fardog/Toast-R-Reflow/hardware/pcb/Controller_II.kicad_pcb

## KiCad design hardware/pcb/Controller_II.kicad_pcb (2021-08-20)

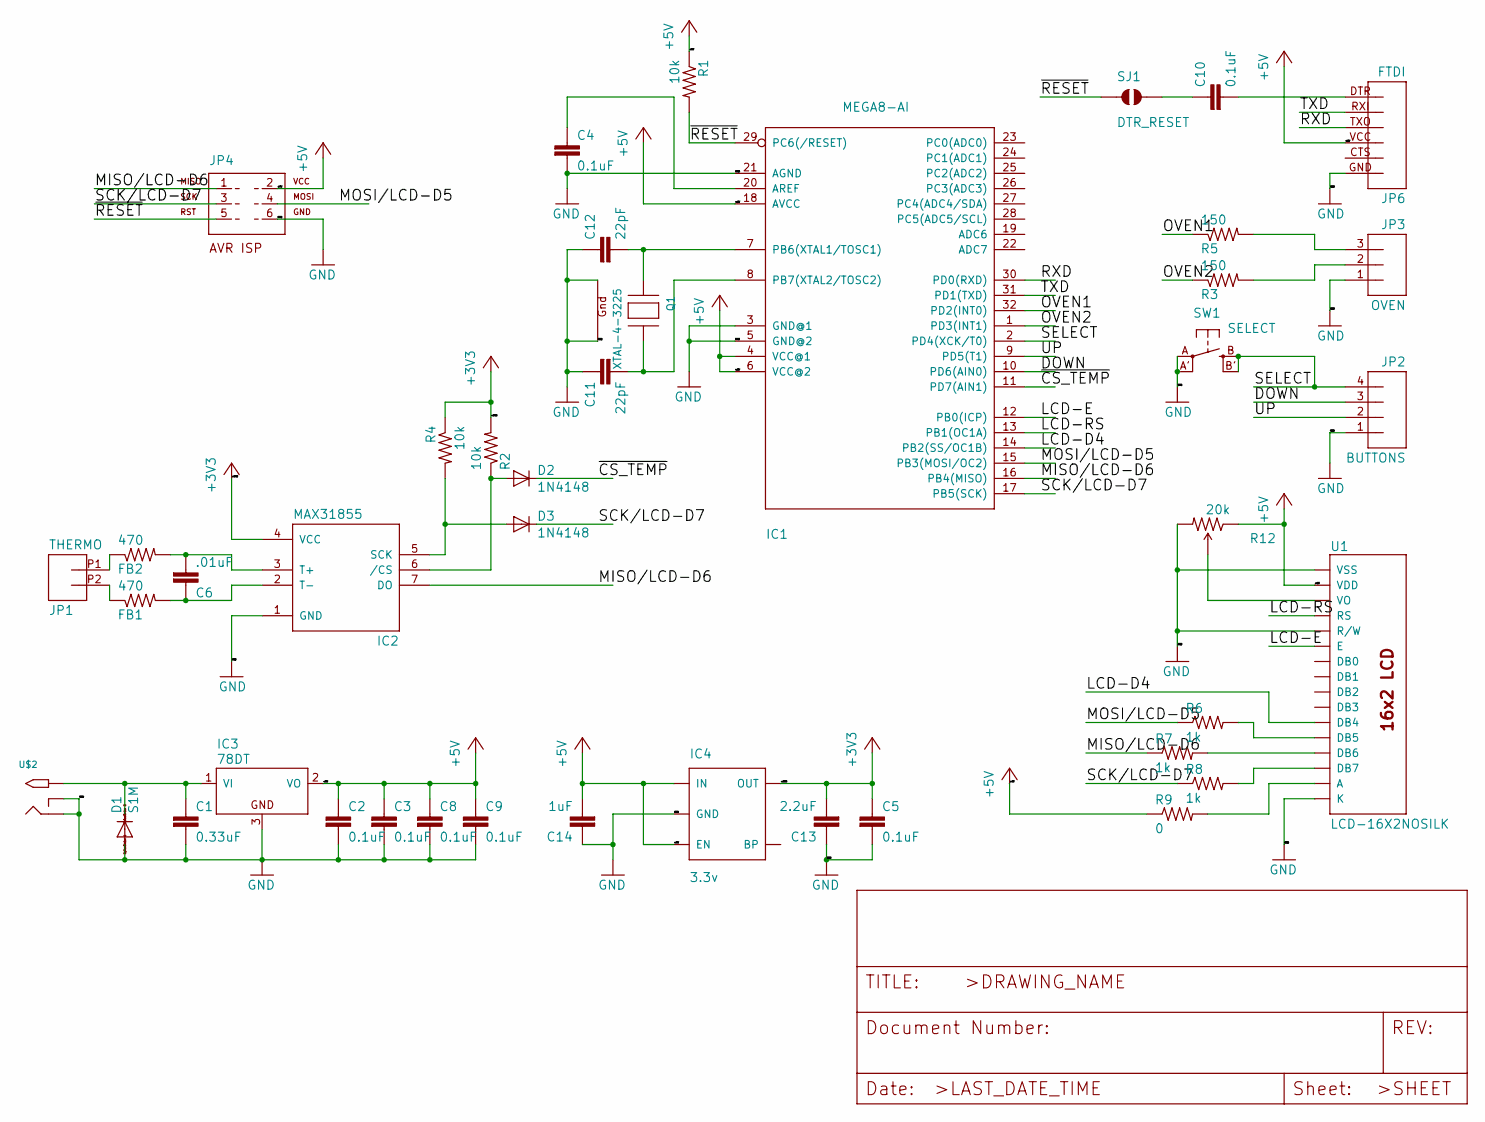
[picture p1: schematic Controller_II.sch]

Parts:
C1: 0.33uF; 0805
C2, C3, C4, C5, C8, C9, C10: 0.1uF; 0805
C6: .01uF; 0805
C11, C12: 22pF; 0805
C13: 2.2uF; 0805
C14: 1uF; 0805
D1: S1M; DO-214AC
D2, D3: 1N4148; SOD-323
FB1, FB2: 470; 0805
IC1: MEGA8-AI; TQFP32-08
IC2: MAX31855; SO08
IC3: 78DT; TO252
IC4: 3.3v; SOT23-5
JP1: THERMO; 1X02_2.54_SCREWTERM
JP2: BUTTONS; 1X04
JP3: OVEN; SCREWTERMINAL-5MM-3
JP4: ISP; AVR-ISP-6
JP6: FTDI; FTDI_BASIC
Q1: XTAL-4-3225; NX3225
R1, R2, R4: 10k; 0805
R3, R5: 150; 0805
R6, R7, R8: 1k; 0805
R9: 0; 0805
R12: 20k; TRIMPOT-3MM
SJ1: DTR_RESET; SJ_2S-NO
SW1: SELECT; EVQ-Q2
U1: LCD-16X2NOSILK; LCD-16X2_NOSILK
U$2: 2.1MMJACKSMT; DCJACK_2MM_SMT

Connections:
+3V3: C5.1, C13.2, IC2.4 (VCC), IC4.5 (OUT), R2.2, R4.1
+5V: C2.1, C3.1, C8.1, C9.1, C14.2, IC1.4 (VCC@1), IC1.6 (VCC@2), IC1.18 (AVCC), IC3.2 (VO), IC4.1 (IN), IC4.3 (EN), JP4.2, JP6.VCC (4), R1.1, R9.1, R12.1 (CCW), U1.2 (VDD)
/DOWN: IC1.10 (PD6(AIN0)), JP2.3
/LCD-D4: IC1.14 (PB2(SS/OC1B)), U1.11 (DB4)
/LCD-E: IC1.12 (PB0(ICP)), U1.6 (E)
/LCD-RS: IC1.13 (PB1(OC1A)), U1.4 (RS)
/MISO/LCD-D6: IC1.16 (PB4(MISO)), IC2.7 (DO), JP4.1, R7.1
/MOSI/LCD-D5: IC1.15 (PB3(MOSI/OC2)), JP4.4, R6.1
/OVEN1: IC1.32 (PD2(INT0)), R5.1
/OVEN2: IC1.1 (PD3(INT1)), R3.1
/RXD: IC1.30 (PD0(RXD)), JP6.TXO (3)
/SCK/LCD-D7: D3.1 (C), IC1.17 (PB5(SCK)), JP4.3, R8.1
/SELECT: IC1.2 (PD4(XCK/T0)), JP2.4, SW1.B (S), SW1.B' (S1)
/TXD: IC1.31 (PD1(TXD)), JP6.RXI (2)
/UP: IC1.9 (PD5(T1)), JP2.2
/~CS_TEMP: D2.1 (C), IC1.11 (PD7(AIN1))
/~RESET: IC1.29 (PC6(/RESET)), JP4.5, R1.2, SJ1.1
GND: C1.2, C2.2, C3.2, C4.2, C5.2, C8.2, C9.2, C11.1, C12.1, C13.1, C14.1, D1.A, IC1.3 (GND@1), IC1.5 (GND@2), IC1.21 (AGND), IC2.1 (GND), IC3.3 (GND), IC4.2 (GND), JP2.1, JP3.1, JP4.6, JP6.GND (6), Q1.2 (G2), Q1.4 (G1), R12.3 (CW), SW1.A, SW1.A' (P1), U1.1 (VSS), U1.5 (R/W), U1.16 (K), U$2.GND (RING), U$2.GNDBREAK (RING_SW)
unnamed: C1.1, D1.C, IC3.1 (VI), U$2.PWR1 (TIP), U$2.PWR2 (TIP)
unnamed: C4.1, IC1.20 (AREF)
unnamed: C6.1, FB1.2, IC2.2 (T-)
unnamed: C6.2, FB2.2, IC2.3 (T+)
unnamed: C10.1, SJ1.2
unnamed: C10.2, JP6.DTR (1)
unnamed: C11.2, IC1.8 (PB7(XTAL2/TOSC2)), Q1.3 (X2)
unnamed: C12.2, IC1.7 (PB6(XTAL1/TOSC1)), Q1.1 (X1)
unnamed: D2.2 (A), IC2.6 (/CS), R2.1
unnamed: D3.2 (A), IC2.5 (SCK), R4.2
unnamed: FB1.1, JP1.P2 (2)
unnamed: FB2.1, JP1.P1 (1)
unnamed: JP3.2, R3.2
unnamed: JP3.3, R5.2
unnamed: R6.2, U1.12 (DB5)
unnamed: R7.2, U1.13 (DB6)
unnamed: R8.2, U1.14 (DB7)
unnamed: R9.2, U1.15 (A)
unnamed: R12.2 (WIPER), U1.3 (VO)

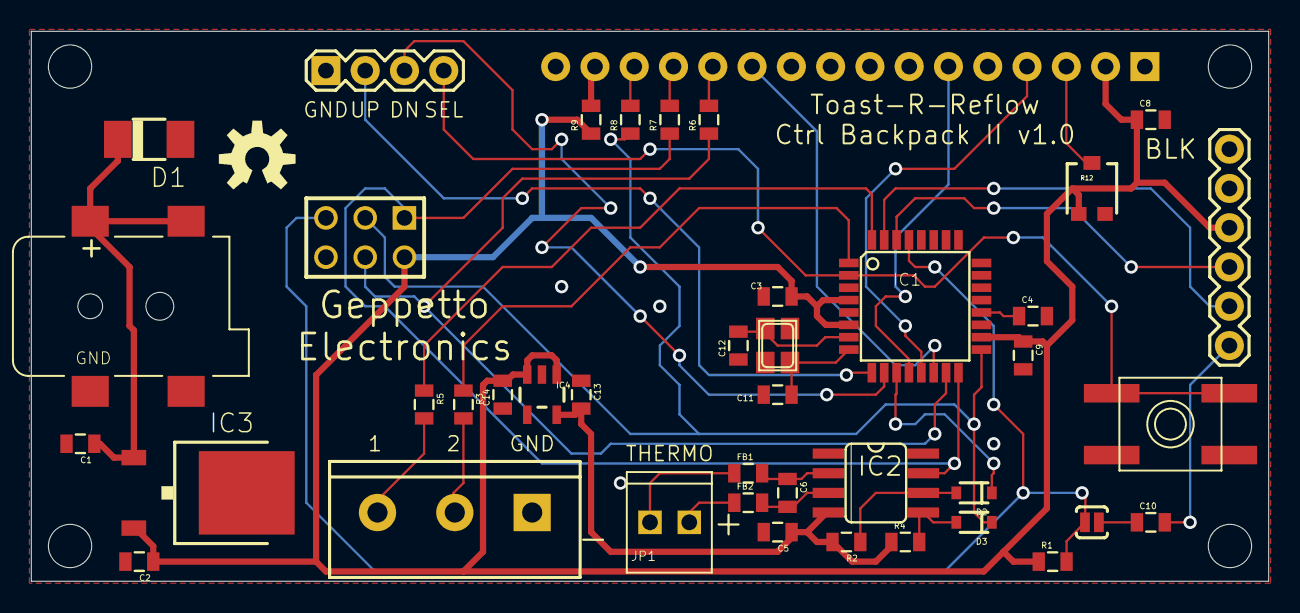
[picture p2: board Controller_II.kicad_pcb from above]

Board: 6 copper layers, 80.0 x 35.6 mm, 43 parts (0 on the bottom side), 37 nets.

Other parts of the board:
U$1: OSHW-LOGO-M
